Taro-Hayashi/On-the-15-mini/img/onthe15mini.png

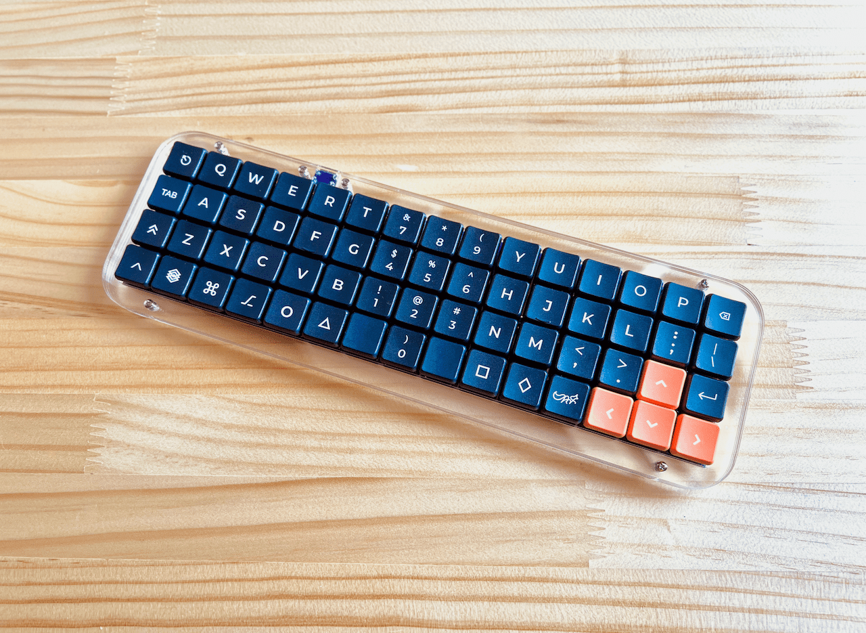
img/onthe15mini.png
